sabas1080/DesignLab-Builds-2023-Education/hardware/Buttons/LeftButtonsDesignLab/LeftButtonsDesignLabBack.png

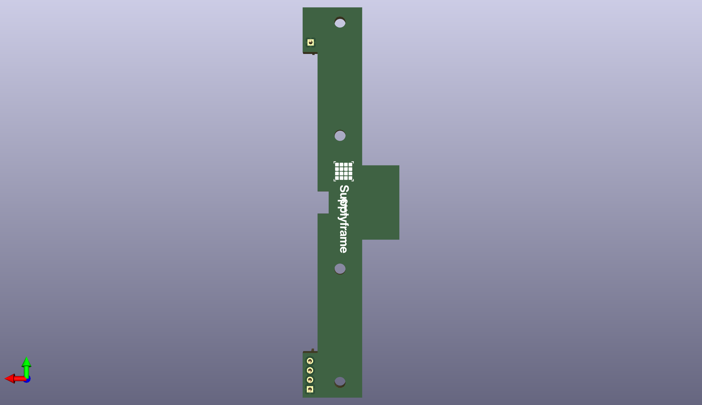
hardware/Buttons/LeftButtonsDesignLab/LeftButtonsDesignLabBack.png
