sabas1080/DesignLab-Builds-2023-Education/README.md

# DesignLab-Builds-2023-Education
DesignLab Builds 2023 - Education
