sabas1080/DesignLab-Builds-2023-Education/hardware/Buttons/LeftButtonsDesignLab/LeftButtonsDesignLab.csv

# | Reference | Qty | Value | Footprint | DNP | LCSC# | manf#
1 | J1 | 1 | Conn_01x04 | Connector_PinHeader_2.54mm:PinHeader_1x04_P2.54mm_Vertical | DNP
2 | J2 | 1 | Conn_01x01 | Connector_PinHeader_2.54mm:PinHeader_1x01_P2.54mm_Vertical | DNP
3 | SW1, SW2, SW3 | 3 | SW_Push | Design:Button |  | C5141768
