sabas1080/DesignLab-Builds-2023-Education/hardware/Buttons/CenterButtonsDesignLab/CenterButtonsDesignLab.step

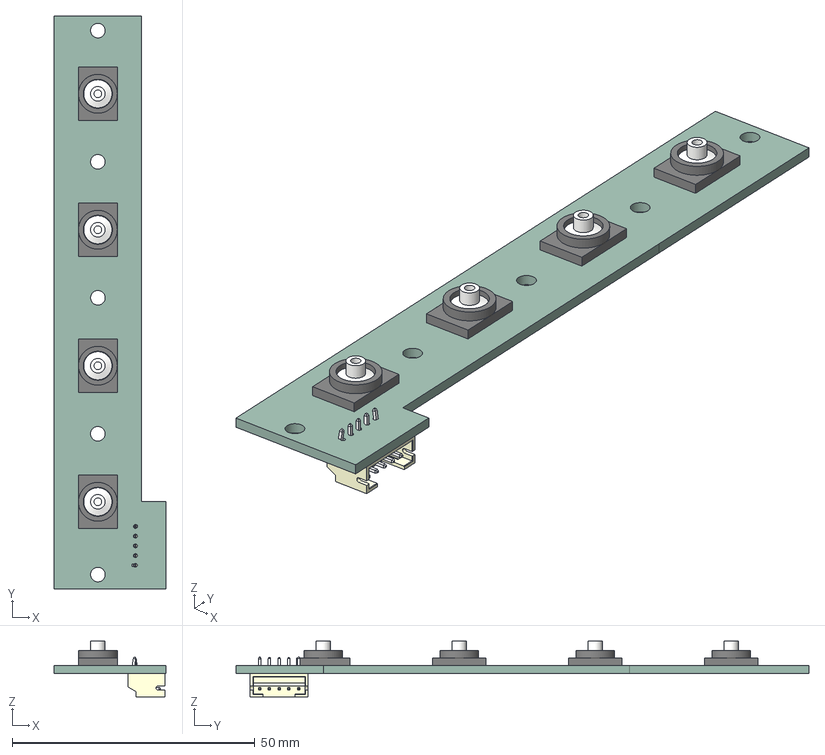
[picture p2: CAD file, 2024-02-01]
hardware/Buttons/CenterButtonsDesignLab/CenterButtonsDesignLab.step
23.0 x 118.0 x 11.5 mm
CenterButtonsDesignLab PCB
