sabas1080/DesignLab-Builds-2023-Education/hardware/Buttons/LeftButtonsDesignLab/LeftButtonsDesignLab.step

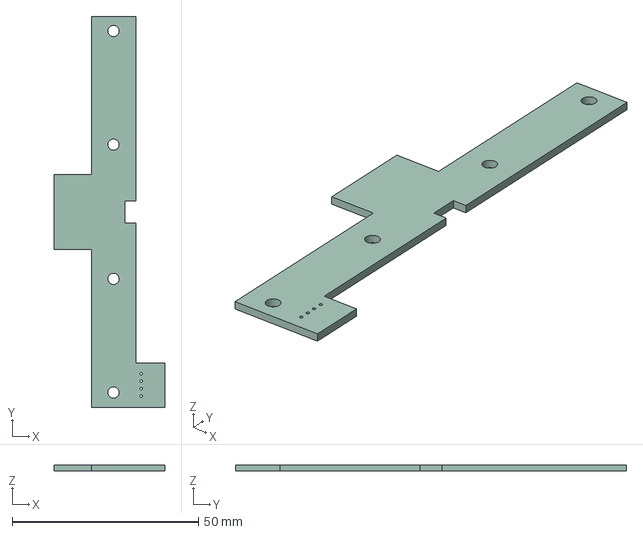
[picture p3: CAD file, 2024-02-01]
hardware/Buttons/LeftButtonsDesignLab/LeftButtonsDesignLab.step
29.8 x 105.0 x 1.60 mm
