sabas1080/DesignLab-Builds-2023-Education/hardware/Buttons/RightButtonsDesignLab/RightButtonsDesignLab.step

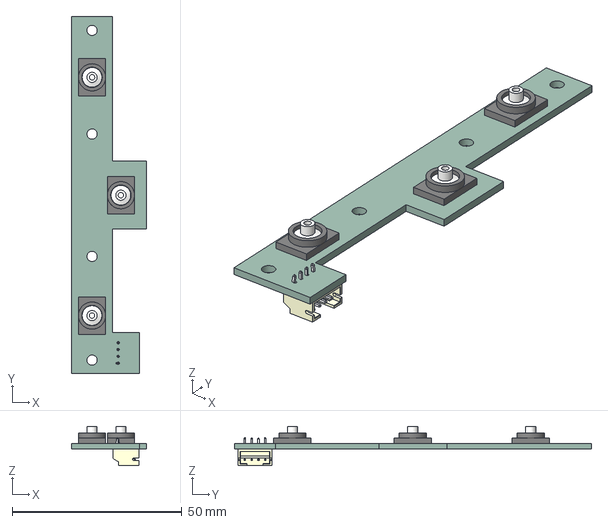
[picture p4: CAD file, 2024-02-01]
hardware/Buttons/RightButtonsDesignLab/RightButtonsDesignLab.step
22.0 x 105.0 x 11.5 mm
RightButtonsDesignLab PCB
