sabas1080/DesignLab-Builds-2023-Education/hardware/DesignLab.step

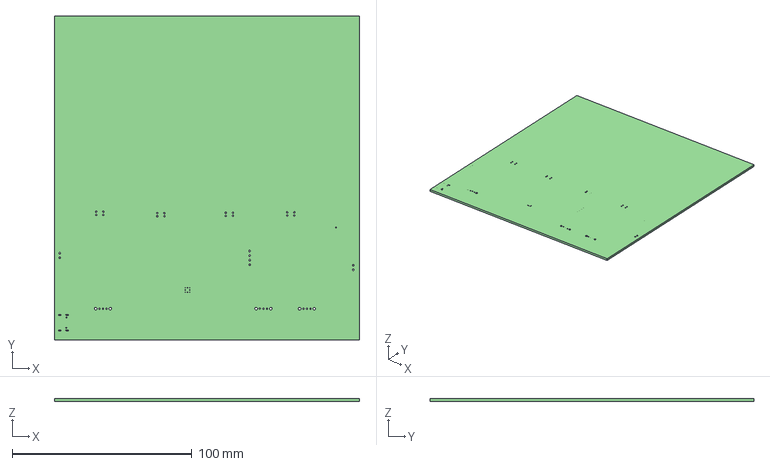
[picture p5: CAD file, 2023-01-20]
hardware/DesignLab.step
169.9 x 180.3 x 1.60 mm
