sabas1080/DesignLab-Builds-2023-Education/hardware/Buttons/CenterButtonsDesignLab/CenterButtonsDesignLab.kicad_pcb

## KiCad design hardware/Buttons/CenterButtonsDesignLab/CenterButtonsDesignLab.kicad_pcb (2024-02-01)

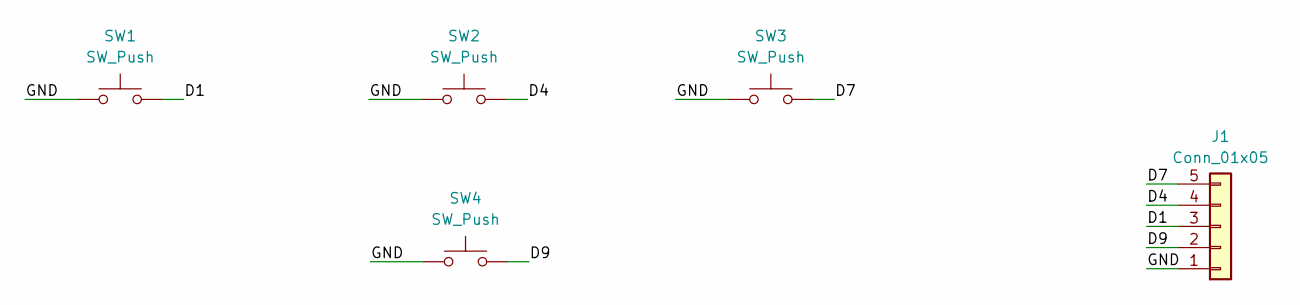
[picture p8: schematic CenterButtonsDesignLab.kicad_sch]

Parts:
J1: Conn_01x05; JST_S5B-PH-K-S_LF__SN_; LCSC# C157923
SW1, SW2, SW3, SW4: SW_Push; Button; LCSC# C5141768

Connections:
/D1: J1.3, SW1.2
/D4: J1.4, SW2.2
/D7: J1.5, SW3.2
/D9: J1.2, SW4.2
/GND: J1.1, SW1.1, SW2.1, SW3.1, SW4.1

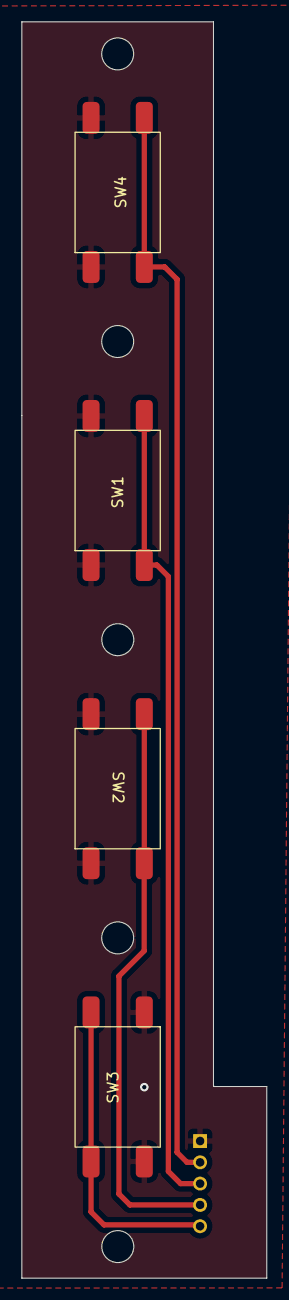
[picture p9: board CenterButtonsDesignLab.kicad_pcb from above]

Board: 2 copper layers, 23.0 x 118.0 mm, 5 parts (1 on the bottom side), 5 nets.
