sabas1080/DesignLab-Builds-2023-Education/hardware/Buttons/LeftButtonsDesignLab/LeftButtonsDesignLab.kicad_pcb

## KiCad design hardware/Buttons/LeftButtonsDesignLab/LeftButtonsDesignLab.kicad_pcb (2024-02-01)

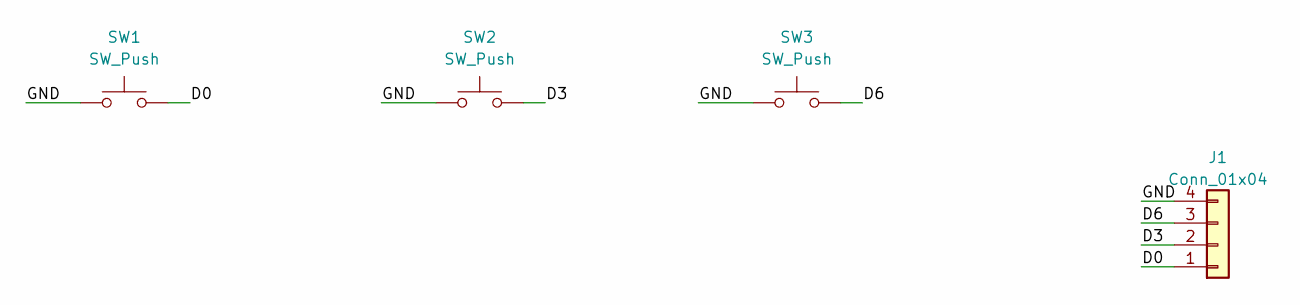
[picture p10: schematic LeftButtonsDesignLab.kicad_sch]

Parts:
J1: Conn_01x04; JST_S4B-PH-K-S_LF__SN_; LCSC# C157926
SW1, SW2, SW3: SW_Push; Button; LCSC# C5141768

Connections:
/D0: J1.1, SW1.2
/D3: J1.2, SW2.2
/D6: J1.3, SW3.2
/GND: J1.4, SW1.1, SW2.1, SW3.1

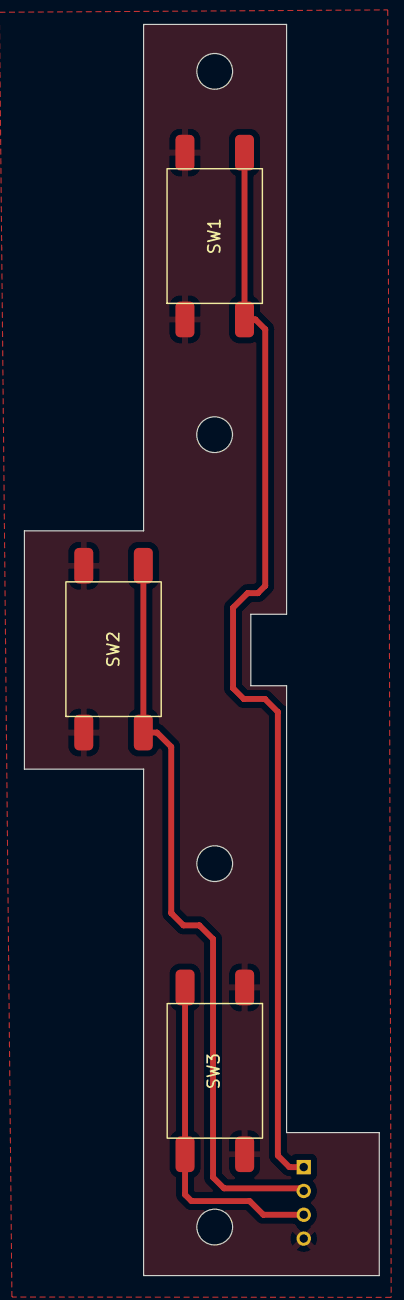
[picture p11: board LeftButtonsDesignLab.kicad_pcb from above]

Board: 2 copper layers, 29.8 x 105.0 mm, 4 parts (1 on the bottom side), 4 nets.
