sabas1080/DesignLab-Builds-2023-Education/hardware/DesignLab.kicad_pcb

## KiCad design hardware/DesignLab.kicad_pcb (2024-02-01)

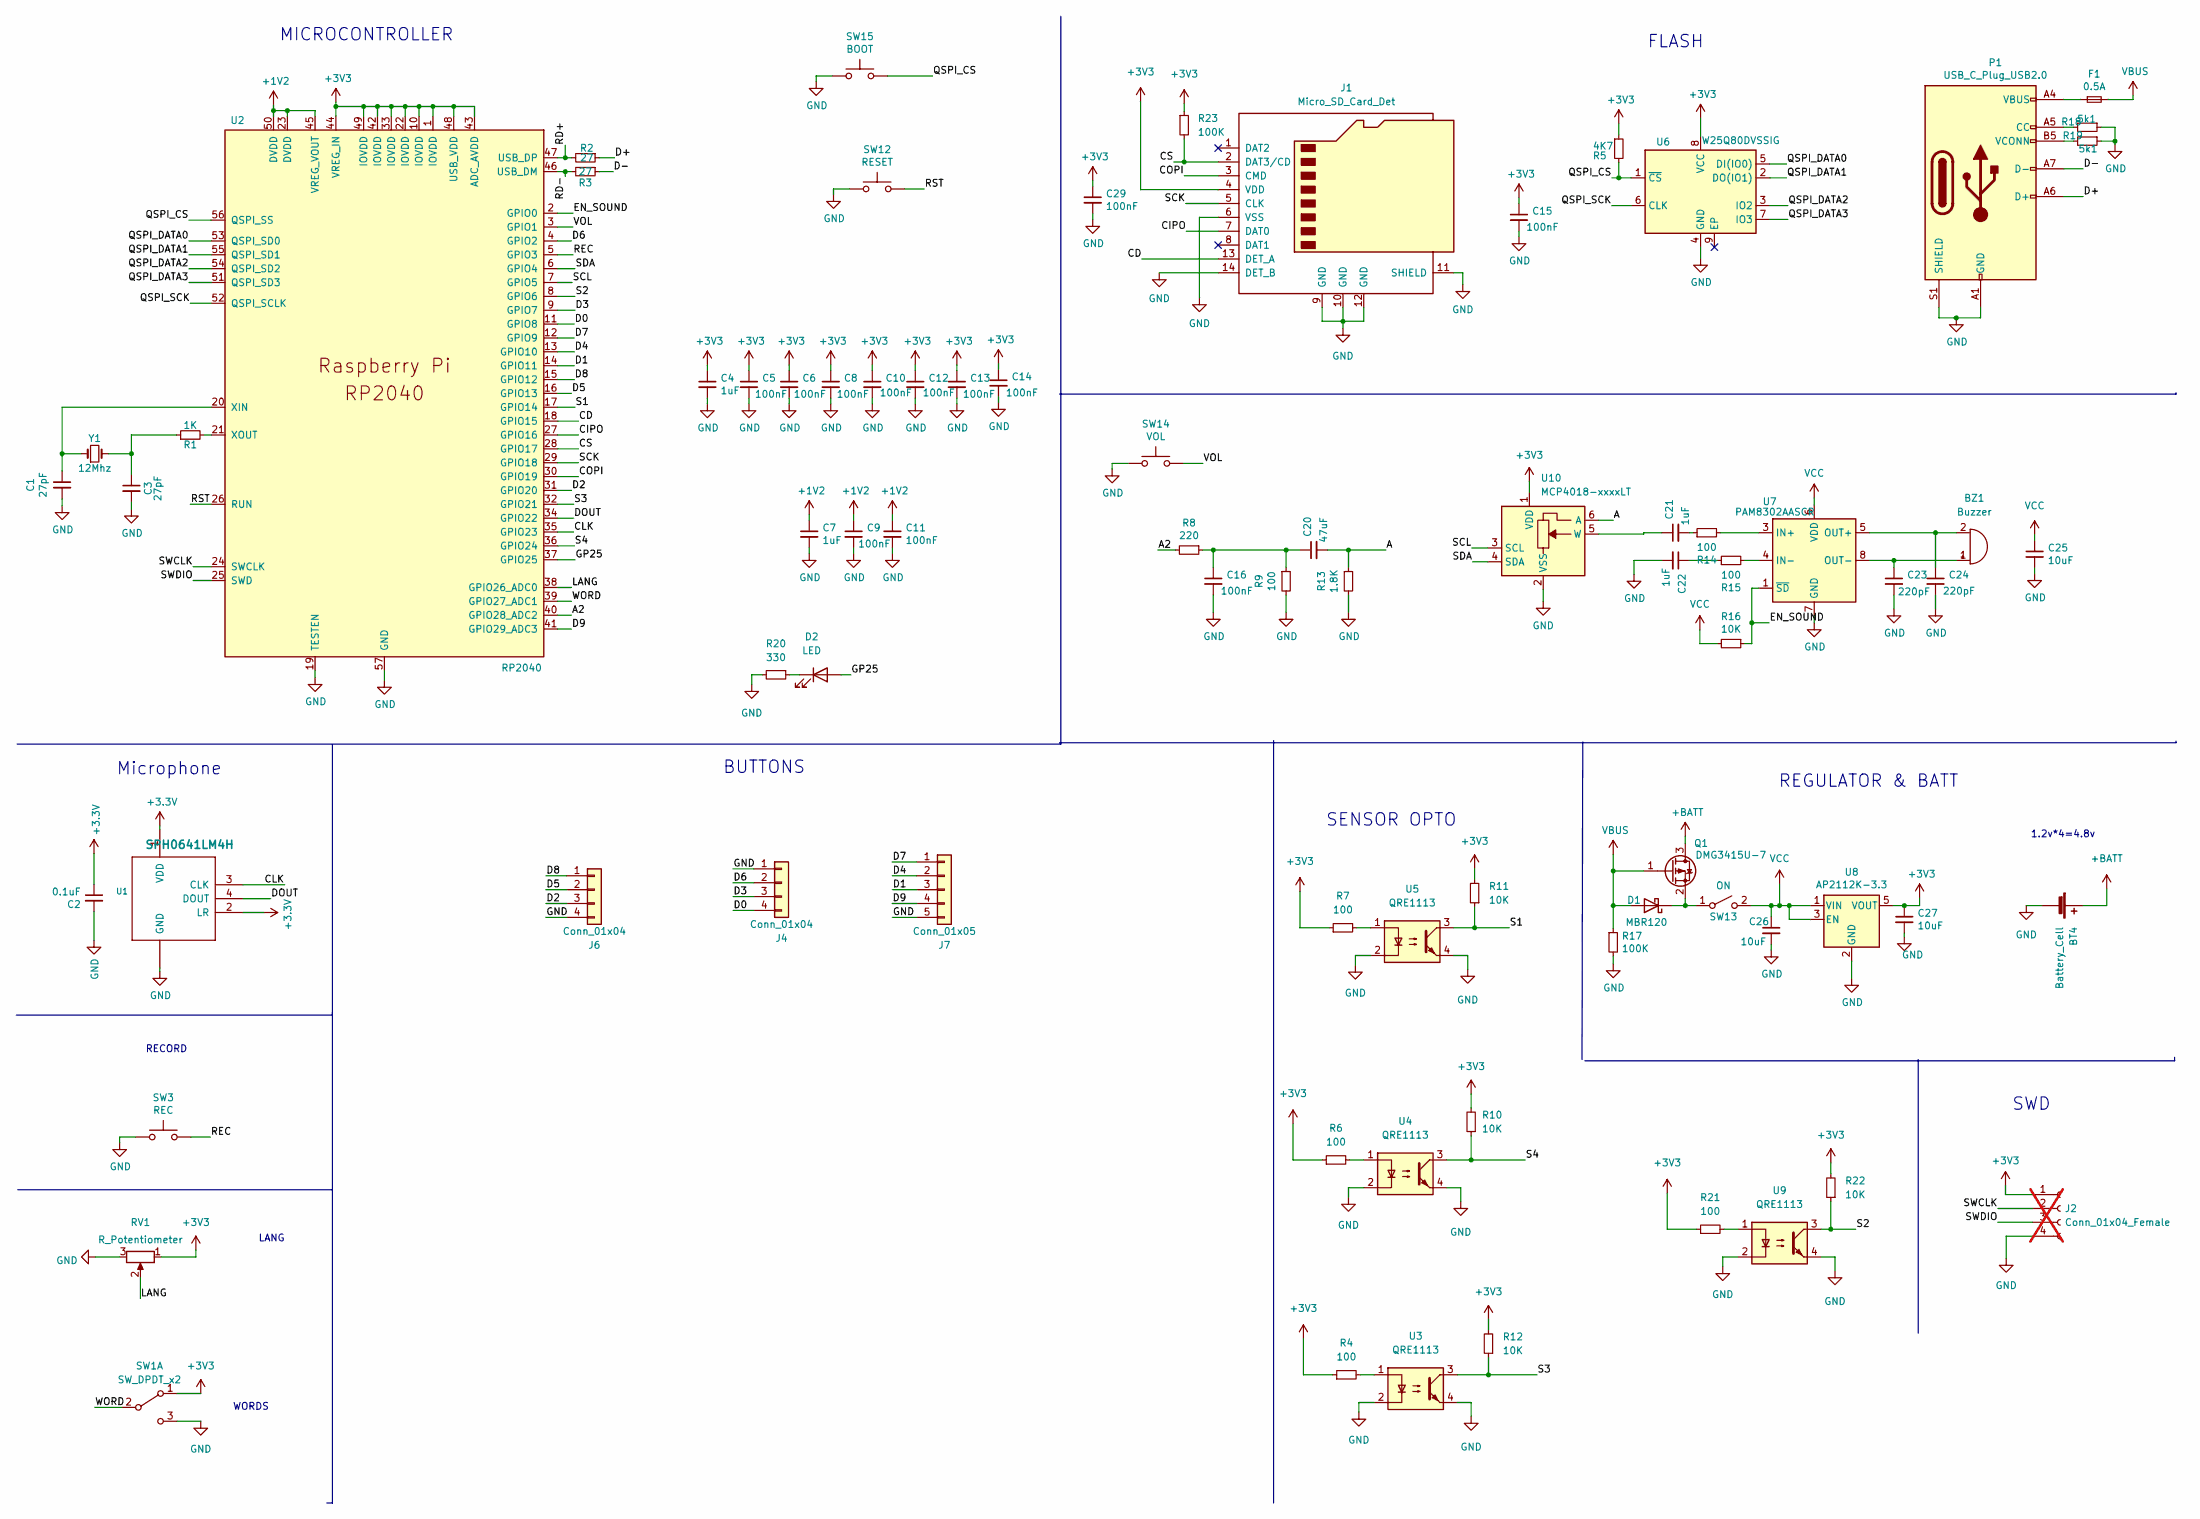
[picture p12: schematic DesignLab.kicad_sch]

Parts:
BT4: Battery_Cell; PinHeader_1x02_P2.54mm_Vertical
BZ1: Buzzer; PinHeader_1x02_P2.54mm_Vertical
C1, C3: 27pF; C_0603_1608Metric
C2: 0.1uF; C_0402_1005Metric_Pad0.74x0.62mm_HandSolder; LCSC# C106209
C4, C7, C21, C22: 1uF; C_0603_1608Metric
C5, C6, C8, C9, C10, C11, C12, C13, C14, C15, C16: 100nF; C_0402_1005Metric_Pad0.74x0.62mm_HandSolder; LCSC# C106209
C20: 47uF; C_0603_1608Metric
C23, C24: 220pF; C_0603_1608Metric; LCSC# C482474
C25, C26, C27: 10uF; C_0402_1005Metric_Pad0.74x0.62mm_HandSolder
C29: 100nF; C_0402_1005Metric; LCSC# C106209
D1: MBR120; SODFL3616X98N
D2: LED; C_0603_1608Metric; LCSC# C118339
F1: 0.5A; Fuse_0805_2012Metric
J1: Micro_SD_Card_Det; 1140084168
J2: Conn_01x04_Female; PinHeader_1x04_P2.54mm_Vertical; not fitted
J4, J6: Conn_01x04; JST_S4B-PH-K-S_LF__SN_; LCSC# C157926
J7: Conn_01x05; JST_S5B-PH-K-S_LF__SN_; LCSC# C157923
P1: USB_C_Plug_USB2.0; C393939; LCSC# C2760486
Q1: DMG3415U-7; SOT-23
R1: 1K; R_0603_1608Metric; LCSC# C115325
R2, R3: 27; R_0603_1608Metric
R4, R6, R7, R21: 100; C_0603_1608Metric; LCSC# C25201
R5: 4K7; R_0603_1608Metric; LCSC# C25999
R8: 220; R_0603_1608Metric; LCSC# C22962
R9, R14, R15: 100; R_0603_1608Metric; LCSC# C25201
R10, R11, R12, R22: 10K; C_0603_1608Metric; LCSC# C99198
R13: 1.8K; R_0603_1608Metric; LCSC# C4177
R16: 10K; R_0603_1608Metric; LCSC# C99198
R17, R23: 100K; R_0603_1608Metric; LCSC# C100048
R18, R19: 5k1; R_0603_1608Metric; LCSC# C156350
R20: 330; R_0603_1608Metric; LCSC# C279996
RV1: R_Potentiometer; PTV09A-4015F-B104_BRN
SW1: SW_DPDT_x2; OS102011MA1QN1
SW3: REC; SW_SPST_TL3342
SW12: RESET; SW_SPST_TL3342
SW13: ON; OS102011MA1QN1
SW14: VOL; SW_SPST_TL3342
SW15: BOOT; SW_SPST_TL3342
U1: SPH0641LM4H; MIC_SPH0641LM4H-1
U2: RP2040; RP2040-QFN-56; LCSC# C2040
U3, U4, U5, U9: QRE1113
U6: W25Q80DVSSIG; SOIC127P798X216-8N
U7: PAM8302AASCR; MSOP-8_3x3mm_P0.65mm
U8: AP2112K-3.3; SOT-23-5
U10: MCP4018-xxxxLT; SOT65P210X110-6N
Y1: 12Mhz; Crystal_SMD_HC49-SD

Connections:
+1V2: C7.1, C9.1, C11.1, U2.23 (DVDD), U2.45 (VREG_VOUT), U2.50 (DVDD)
+BATT: BT4.1 (+), Q1.3 (D)
/A: C20.2, R13.1, U10.6 (A)
/A2: R8.2, U2.40 (GPIO28_ADC2)
/CD: J1.13 (DET_A), U2.18 (GPIO15)
/CIPO: J1.7 (DAT0), U2.27 (GPIO16)
/CLK: U1.3 (CLK), U2.35 (GPIO23)
/COPI: J1.3 (CMD), U2.30 (GPIO19)
/CS: J1.2 (DAT3/CD), R23.2, U2.28 (GPIO17)
/D0: J4.4, U2.11 (GPIO8)
/D1: J7.3, U2.14 (GPIO11)
/D2: J6.3, U2.31 (GPIO20)
/D3: J4.3, U2.9 (GPIO7)
/D4: J7.2, U2.13 (GPIO10)
/D5: J6.2, U2.16 (GPIO13)
/D6: J4.2, U2.4 (GPIO2)
/D7: J7.1, U2.12 (GPIO9)
/D8: J6.1, U2.15 (GPIO12)
/D9: J7.4, U2.41 (GPIO29_ADC3)
/D+: P1.A6 (D+), R2.1
/D-: P1.A7 (D-), R3.1
/DOUT: U1.4 (DOUT), U2.34 (GPIO22)
/EN_SOUND: R16.1, U2.2 (GPIO0), U7.1 (~SD)
/GP25: D2.2 (A), U2.37 (GPIO25)
/LANG: RV1.2, U2.38 (GPIO26_ADC0)
/QSPI_CS: R5.2, SW15.2, U2.56 (QSPI_SS), U6.1 (~CS)
/QSPI_DATA0: U2.53 (QSPI_SD0), U6.5 (DI(IO0))
/QSPI_DATA1: U2.55 (QSPI_SD1), U6.2 (DO(IO1))
/QSPI_DATA2: U2.54 (QSPI_SD2), U6.3 (IO2)
/QSPI_DATA3: U2.51 (QSPI_SD3), U6.7 (IO3)
/QSPI_SCK: U2.52 (QSPI_SCLK), U6.6 (CLK)
/RD+: R2.2, U2.47 (USB_DP)
/RD-: R3.2, U2.46 (USB_DM)
/REC: SW3.2, U2.5 (GPIO3)
/RST: SW12.2, U2.26 (RUN)
/S1: R11.1, U2.17 (GPIO14), U5.3
/S2: R22.1, U2.8 (GPIO6), U9.3
/S3: R12.1, U2.32 (GPIO21), U3.3
/S4: R10.1, U2.36 (GPIO24), U4.3
/SCK: J1.5 (CLK), U2.29 (GPIO18)
/SCL: U2.7 (GPIO5), U10.3 (SCL)
/SDA: U2.6 (GPIO4), U10.4 (SDA)
/SWCLK: J2.2, U2.24 (SWCLK)
/SWDIO: J2.3, U2.25 (SWD)
/VOL: SW14.2, U2.3 (GPIO1)
/WORD: SW1.2 (B), U2.39 (GPIO27_ADC1)
GND: BT4.2 (-), C1.2, C2.2, C3.2, C4.2, C5.2, C6.2, C7.2, C8.2, C9.2, C10.2, C11.2, C12.2, C13.2, C14.2, C15.2, C16.2, C22.2, C23.2, C24.2, C25.2, C26.2, C27.2, C29.2, J1.6 (VSS), J1.9 (GND), J1.10 (GND), J1.11 (SHIELD), J1.12 (GND), J1.14 (DET_B), J2.4, J4.1, J6.4, J7.5, P1.A1 (GND), P1.A12 (GND), P1.B1 (GND), P1.B12 (GND), P1.S1 (SHIELD), R9.2, R13.2, R17.2, R18.1, R19.1, R20.2, RV1.3, SW1.3 (C), SW3.1, SW12.1, SW14.1, SW15.1, U1.5 (GND), U1.GND@2 (GND), U1.GND@3 (GND), U1.GND@4 (GND), U2.19 (TESTEN), U2.57 (GND), U3.2, U3.4, U4.2, U4.4, U5.2, U5.4, U6.4 (GND), U7.7 (GND), U8.2 (GND), U9.2, U9.4, U10.2 (VSS)
unnamed: BZ1.2 (+), C24.1, U7.5 (OUT+)
unnamed: BZ1.1 (-), C23.1, U7.8 (OUT-)
unnamed: C3.1, R1.1, Y1.2
unnamed: C16.1, C20.1, R8.1, R9.1
unnamed: C21.2, R14.1
unnamed: C22.1, R15.1
unnamed: D1.1 (K), Q1.2 (S), SW13.1 (A)
unnamed: D2.1 (K), R20.1
unnamed: F1.1, P1.A4 (VBUS), P1.A9 (VBUS), P1.B4 (VBUS), P1.B9 (VBUS)
unnamed: P1.A5 (CC), R18.2
unnamed: P1.B5 (VCONN), R19.2
unnamed: R4.2, U3.1
unnamed: R6.2, U4.1
unnamed: R7.2, U5.1
unnamed: R21.2, U9.1
unnamed: C1.1, U2.20 (XIN), Y1.1
unnamed: R1.2, U2.21 (XOUT)
unnamed: R14.2, U7.3 (IN+)
unnamed: R15.2, U7.4 (IN-)
unnamed: C21.1, U10.5 (W)
VBUS: D1.2 (A), F1.2, Q1.1 (G), R17.1
VCC: C25.1, C26.1, R16.2, SW13.2 (B), U7.6 (VDD), U8.1 (VIN), U8.3 (EN)

Notes on the sheet:
REGULATOR & BATT
LANG
SWD
1.2v*4=4.8v
WORDS
FLASH
RECORD
SENSOR OPTO
Microphone
BUTTONS
MICROCONTROLLER

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
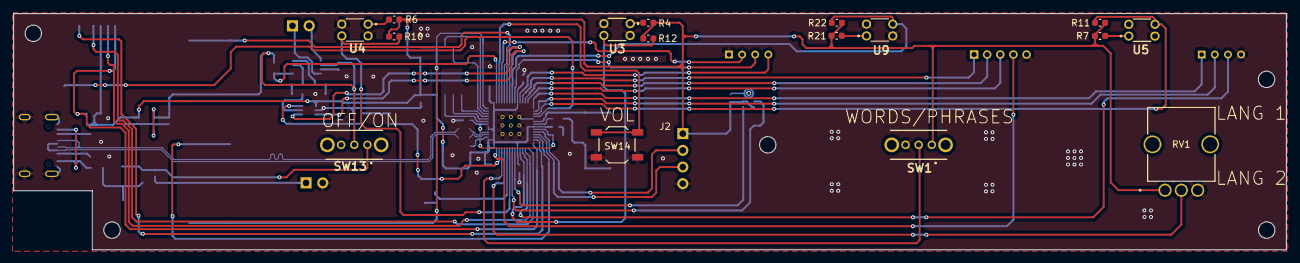
[picture p13: board DesignLab.kicad_pcb from above]

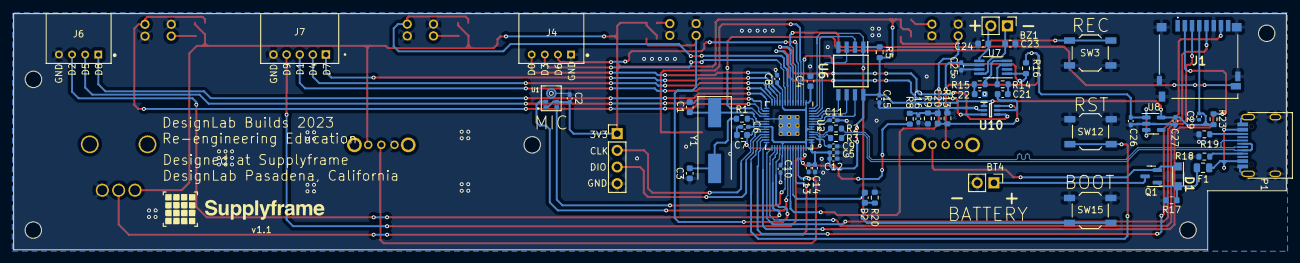
[picture p14: board DesignLab.kicad_pcb from below]

Board: 2 copper layers, 194.0 x 36.0 mm, 78 parts (62 on the bottom side), 70 nets.
