sabas1080/DesignLab-Builds-2023-Education/(commit log)

2022-12-25 init Schematic
    [DesignLab.kicad_pcb, DesignLab.kicad_sch, DesignLab.sch]
2023-01-04 Add buttons, change memory, fix GPIOs
    [DesignLab.kicad_sch]
2023-01-05 Starting BOM
    [DesignLab.kicad_sch]
2023-01-11 Update BOM
    [DesignLab.kicad_sch]
2023-01-12 Add Micro SD, digital Pot
    [DesignLab.kicad_sch]
2023-01-14 add sensor and change button reset
    [DesignLab.kicad_sch]
2023-01-14 change LED_BUILTIN
    [DesignLab.kicad_sch]
2023-01-14 fix buttons
    [DesignLab.kicad_sch]
2023-01-14 define buttons
2023-01-16 define pins buttons and more
2023-01-18 Assigned footprints
    [DesignLab.kicad_pcb, DesignLab.kicad_sch]
2023-01-18 PCB design proposal
    [DesignLab.kicad_pcb, DesignLab.kicad_sch]
2023-01-18 More PCB design proposal
    [DesignLab.kicad_pcb]
2023-01-18 Corrected BOM
    [DesignLab.kicad_sch]
2023-01-19 Update foorplan
    [DesignLab.kicad_pcb]
2023-01-20 Newly updated BOM
    [DesignLab.kicad_sch]
2023-01-20 PCB layout and .step file
    [DesignLab.kicad_pcb, DesignLab.step]
2023-01-20 new size
    [DesignLab.kicad_pcb, DesignLab.step]
2023-01-20 move buttons
    [DesignLab.kicad_pcb]
2023-01-24 Started routing and BOM corrected
    [DesignLab.kicad_pcb, DesignLab.kicad_sch]
2023-01-24 Proposal PCB routing
    [DesignLab.kicad_pcb, DesignLab.kicad_sch]
2023-01-25 Routing corrected
    [DesignLab.kicad_pcb, DesignLab.kicad_sch]
2023-01-25 Button flipped
    [DesignLab.kicad_pcb, DesignLab.kicad_sch]
2023-01-30 add 3D files
    [DesignLab.kicad_pcb]
2023-01-30 add button 3D
    [DesignLab.kicad_pcb]
2023-01-31 3D model assigned
    [DesignLab.kicad_pcb, DesignLab.kicad_sch]
2023-01-31 Change all 3D models to .step
    [DesignLab.kicad_pcb]
2023-02-17 Corrections to the schematic and the PCB
    [DesignLab.kicad_pcb, DesignLab.kicad_sch]
2023-02-19 Sensors corrected
    [DesignLab.kicad_pcb]
2023-02-20 Fix pin EN_SOUND
    [DesignLab.kicad_sch]
2023-02-21 EN_SOUND routed
    [DesignLab.kicad_pcb]
2023-02-22 Buttons were changed, routed and assigned another pin
    [DesignLab.kicad_pcb, DesignLab.kicad_sch]
2023-02-23 Rounded PCB and added new labels
    [DesignLab.kicad_pcb, DesignLab.kicad_sch]
2023-02-27 PCB modified and generated another design with the button
    [ButtonDesignLab.kicad_pcb, ButtonDesignLab.kicad_sch, DesignLab.kicad_pcb, DesignLab.kicad_sch]
2023-02-27 add led blink
2023-02-27 Update label battery
    [DesignLab.kicad_pcb]
2023-03-01 New PCB routing started
    [DesignLab.kicad_pcb]
2023-03-02 Almost finished the PCB and started with the PCB of buttons
    [ButtonDesignLab.kicad_pcb, ButtonDesignLab.kicad_sch, DesignLab.kicad_pcb]
2023-03-02 Update button and Kicad7
    [DesignLab.kicad_pcb, DesignLab.kicad_sch]
2023-03-02 update font
    [DesignLab.kicad_pcb]
2023-03-03 PCB routing finished
    [DesignLab.kicad_pcb, DesignLab.kicad_sch]
2023-03-03 add labels buttons
    [DesignLab.kicad_pcb]
2023-03-05 Finished button PCBs
    [ButtonDesignLab.kicad_pcb, ButtonDesignLab.kicad_sch, CenterButtonsDesignLab.kicad_pcb, CenterButtonsDesignLab.kicad_sch, DesignLab.kicad_pcb, DesignLab.kicad_sch, LeftButtonsDesignLab.kicad_pcb, LeftButtonsDesignLab.kicad_sch]
2023-03-06 update labels buttons
    [CenterButtonsDesignLab.kicad_pcb, LeftButtonsDesignLab.kicad_pcb, RightButtonsDesignLab.kicad_pcb]
2023-03-06 Update label main
    [DesignLab.kicad_pcb]
2023-03-06 Update labels
    [CenterButtonsDesignLab.kicad_pcb, LeftButtonsDesignLab.kicad_pcb, RightButtonsDesignLab.kicad_pcb]
2023-03-06 remove old buttons
    [ButtonDesignLab.kicad_pcb, ButtonDesignLab.kicad_sch]
2023-03-06 v1.0 for production
    [CenterButtonsDesignLab.kicad_pcb, DesignLab.kicad_pcb, LeftButtonsDesignLab.kicad_pcb, RightButtonsDesignLab.kicad_pcb]
2023-03-23 PCB of the middle buttons changed
    [CenterButtonsDesignLab.kicad_pcb]
2023-03-27 Changed PCB of central buttons
    [CenterButtonsDesignLab.kicad_pcb]
2023-03-29 Update firmware to PCB v1.1
2023-03-29 Update firmware to PCB v2.0
2023-03-31 add button 9
2023-04-04 fix select page 7
    [EducationDesignLab.ino]
2023-04-06 add button 8 validate
2023-04-14 SD, USB and labels changed
    [CenterButtonsDesignLab.kicad_pcb, DesignLab.kicad_pcb, LeftButtonsDesignLab.kicad_pcb, RightButtonsDesignLab.kicad_pcb]
2023-04-14 fix labels
    [DesignLab.kicad_pcb]
2023-04-14 fix labels buttons
    [CenterButtonsDesignLab.kicad_pcb, LeftButtonsDesignLab.kicad_pcb, RightButtonsDesignLab.kicad_pcb]
2023-04-14 labels buttons
    [CenterButtonsDesignLab.kicad_pcb, DesignLab.kicad_pcb, LeftButtonsDesignLab.kicad_pcb, RightButtonsDesignLab.kicad_pcb]
2023-04-15 Footprint of the switch lang changed
    [DesignLab.kicad_pcb, DesignLab.kicad_sch]
2023-04-18 add 3d buttons
    [CenterButtonsDesignLab.kicad_pcb, LeftButtonsDesignLab.kicad_pcb, RightButtonsDesignLab.kicad_pcb]
2023-04-18 fix label gnd
    [LeftButtonsDesignLab.kicad_pcb]
2023-04-19 setup gerbers v1.1
    [CenterButtonsDesignLab.kicad_pcb, DesignLab.kicad_pcb, LeftButtonsDesignLab.kicad_pcb, RightButtonsDesignLab.kicad_pcb]
2023-05-10 BOM changed
    [DesignLab.csv, DesignLab.kicad_pcb, DesignLab.kicad_sch]
2023-05-10 BOM of buttons generated
    [CenterButtonsDesignLab.csv, CenterButtonsDesignLab.kicad_sch, LeftButtonsDesignLab.csv, LeftButtonsDesignLab.kicad_sch, RightButtonsDesignLab.csv, RightButtonsDesignLab.kicad_sch]
2023-05-16 .csv corrected
    [DesignLab.csv]
2023-05-17 Q1 and D1 changed in BOM
    [DesignLab.csv, DesignLab.kicad_sch]
2023-08-08 fix cadena 2 button i
    [EducationDesignLab.ino]
2023-08-18 print size file and converter wav to wav
2023-09-15 Changes of button started
    [CenterButtonsDesignLab.kicad_pcb, CenterButtonsDesignLab.kicad_sch, DesignLab.kicad_pcb]
2023-09-20 New changes in the center buttons
    [CenterButtonsDesignLab.kicad_pcb, CenterButtonsDesignLab.step]
2023-09-23 Label switch changed and D9 added
    [DesignLab.kicad_pcb, DesignLab.kicad_sch]
2023-12-21 fix update pwm_init
2024-01-23 Update all PCB and schematics
    [CenterButtonsDesignLab.kicad_pcb, CenterButtonsDesignLab.kicad_sch, DesignLab.kicad_pcb, DesignLab.kicad_sch, LeftButtonsDesignLab.kicad_pcb, LeftButtonsDesignLab.kicad_sch, RightButtonsDesignLab.kicad_pcb, RightButtonsDesignLab.kicad_sch]
2024-01-30 .steps generated
    [CenterButtonsDesignLab.kicad_pcb, CenterButtonsDesignLab.step, DesignLab.kicad_pcb, LeftButtonsDesignLab.kicad_pcb, LeftButtonsDesignLab.step, RightButtonsDesignLab.kicad_pcb, RightButtonsDesignLab.step]
2024-01-31 .step of potentiometer changed
    [DesignLab.kicad_pcb]
2024-02-01 Update PCB
    [CenterButtonsDesignLab.kicad_pcb, CenterButtonsDesignLab.kicad_sch, CenterButtonsDesignLab.step, DesignLab.kicad_pcb, LeftButtonsDesignLab.kicad_pcb, RightButtonsDesignLab.kicad_pcb, RightButtonsDesignLab.kicad_sch, RightButtonsDesignLab.step]
2024-02-01 Update PCB of buttons
    [LeftButtonsDesignLab.kicad_pcb, RightButtonsDesignLab.kicad_pcb]
2024-02-01 .steps updated
    [DesignLab.csv, LeftButtonsDesignLab.step, RightButtonsDesignLab.kicad_pcb, RightButtonsDesignLab.step]
2024-02-01 Update label buttons
    [CenterButtonsDesignLab.kicad_pcb, RightButtonsDesignLab.kicad_pcb]
2024-02-28 feat!: new button 10 and rename button
